peakhunt/chinese-diesel-heater-esp32/README.md

# Hello World Example

Dangerous! No safety functions implemented on purpose of  
full manual control!
