peakhunt/chinese-diesel-heater-esp32/how_to_build.txt

# install vue cli
npm install -g @vue/cli

# build web front
cd web-front
npm install
npm run build

#
