peakhunt/chinese-diesel-heater-esp32/pcb/diesel-heater-esp32.kicad_pcb

## KiCad design pcb/diesel-heater-esp32.kicad_pcb (2021-02-26)

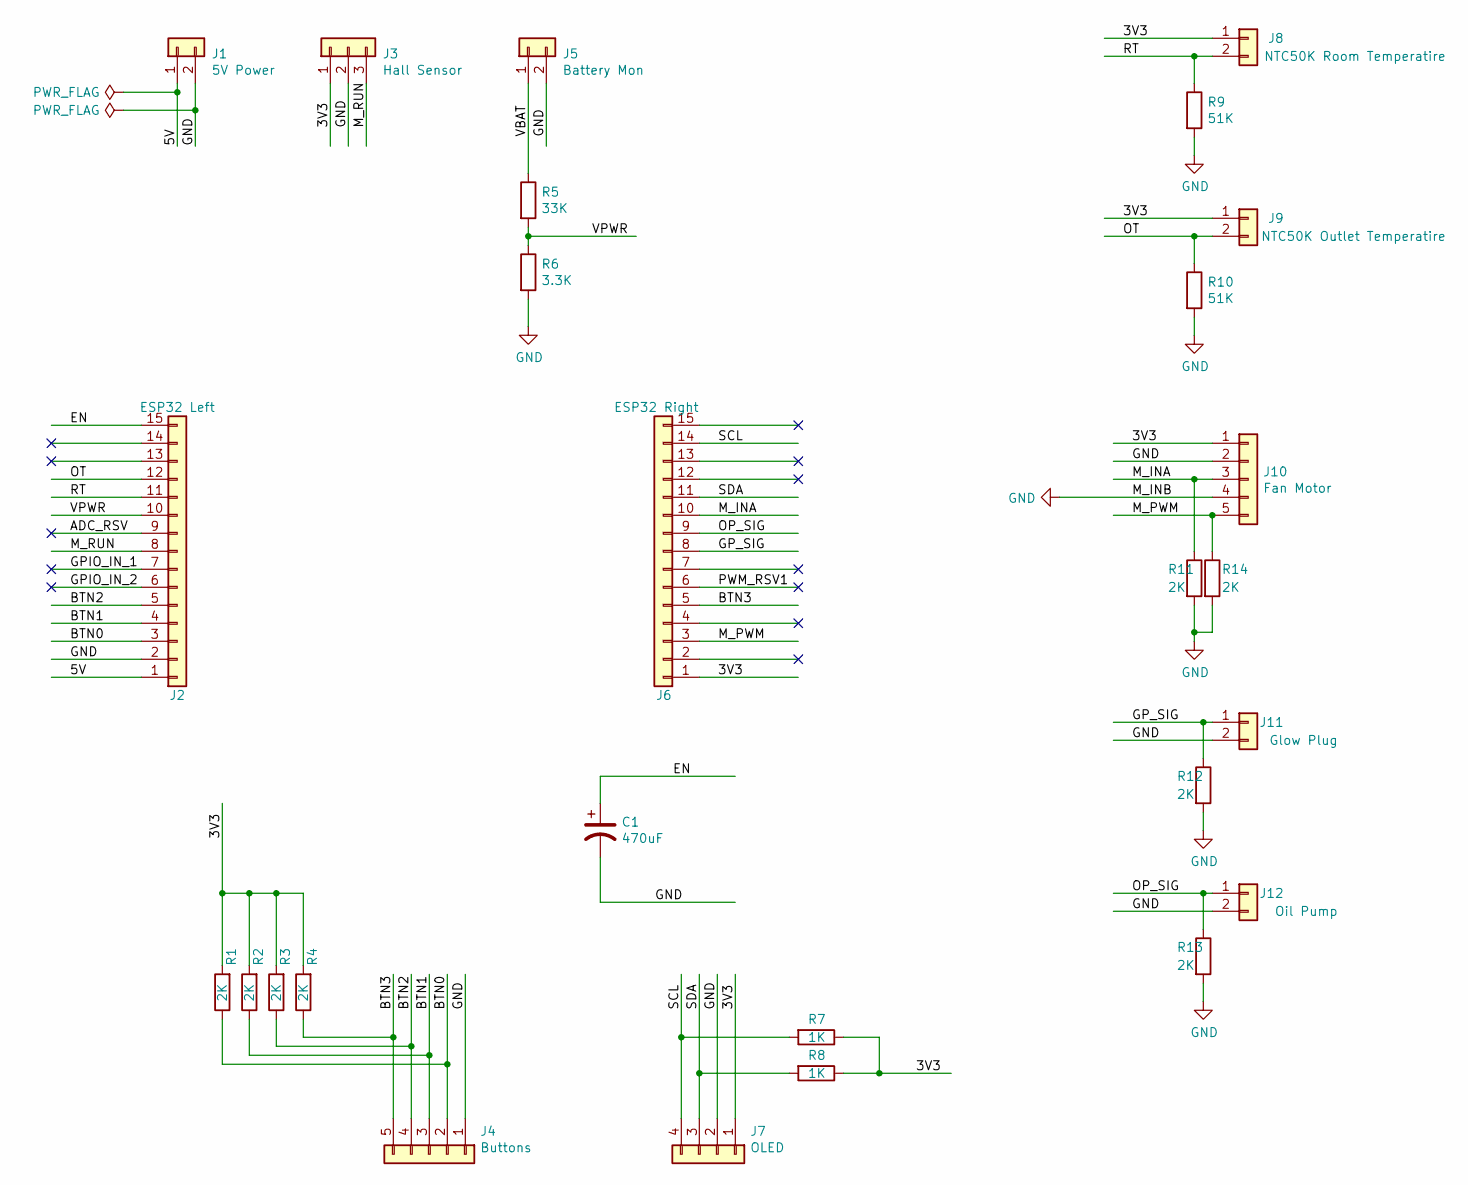
[picture p1: schematic diesel-heater-esp32.sch]

Parts:
C1: 470uF; CP_Radial_D6.3mm_P2.50mm
J1: 5V Power; JST_EH_B2B-EH-A_1x02_P2.50mm_Vertical
J2: ESP32 Left; PinSocket_1x15_P2.54mm_Vertical
J3: Hall Sensor; JST_EH_B3B-EH-A_1x03_P2.50mm_Vertical
J4: Buttons; JST_EH_B5B-EH-A_1x05_P2.50mm_Vertical
J5: Battery Mon; JST_EH_B2B-EH-A_1x02_P2.50mm_Vertical
J6: ESP32 Right; PinSocket_1x15_P2.54mm_Vertical
J7: OLED; JST_EH_B4B-EH-A_1x04_P2.50mm_Vertical
J8: NTC50K Room Temperatire; JST_EH_B2B-EH-A_1x02_P2.50mm_Vertical
J9: NTC50K Outlet Temperatire; JST_EH_B2B-EH-A_1x02_P2.50mm_Vertical
J10: Fan Motor; JST_EH_B5B-EH-A_1x05_P2.50mm_Vertical
J11: Glow Plug; JST_EH_B2B-EH-A_1x02_P2.50mm_Vertical
J12: Oil Pump; JST_EH_B2B-EH-A_1x02_P2.50mm_Vertical
R1, R2, R3, R4, R11, R12, R13, R14: 2K; R_0603_1608Metric_Pad0.98x0.95mm_HandSolder
R5: 33K; R_0603_1608Metric_Pad0.98x0.95mm_HandSolder
R6: 3.3K; R_0603_1608Metric_Pad0.98x0.95mm_HandSolder
R7, R8: 1K; R_0603_1608Metric_Pad0.98x0.95mm_HandSolder
R9, R10: 51K; R_0603_1608Metric_Pad0.98x0.95mm_HandSolder

Connections:
/3V3: J3.1, J6.1, J7.1, J8.1, J9.1, J10.1, R1.2, R2.2, R3.2, R4.2, R7.1, R8.1
/5V: J1.1, J2.1
/ADC_RSV: J2.9
/BTN0: J2.3, J4.2, R1.1
/BTN1: J2.4, J4.3, R2.1
/BTN2: J2.5, J4.4, R3.1
/BTN3: J4.5, J6.5, R4.1
/EN: C1.1, J2.15
/GPIO_IN_1: J2.7
/GPIO_IN_2: J2.6
/GP_SIG: J6.8, J11.1, R12.1
/M_INA: J6.10, J10.3, R11.1
/M_PWM: J6.3, J10.5, R14.1
/M_RUN: J2.8, J3.3
/OP_SIG: J6.9, J12.1, R13.1
/OT: J2.12, J9.2, R10.1
/PWM_RSV1: J6.6
/RT: J2.11, J8.2, R9.1
/SCL: J6.14, J7.4, R7.2
/SDA: J6.11, J7.3, R8.2
/VBAT: J5.1, R5.1
/VPWR: J2.10, R5.2, R6.1
GND: C1.2, J1.2, J2.2, J3.2, J4.1, J5.2, J7.2, J10.2, J10.4, J11.2, J12.2, R6.2, R9.2, R10.2, R11.2, R12.2, R13.2, R14.2

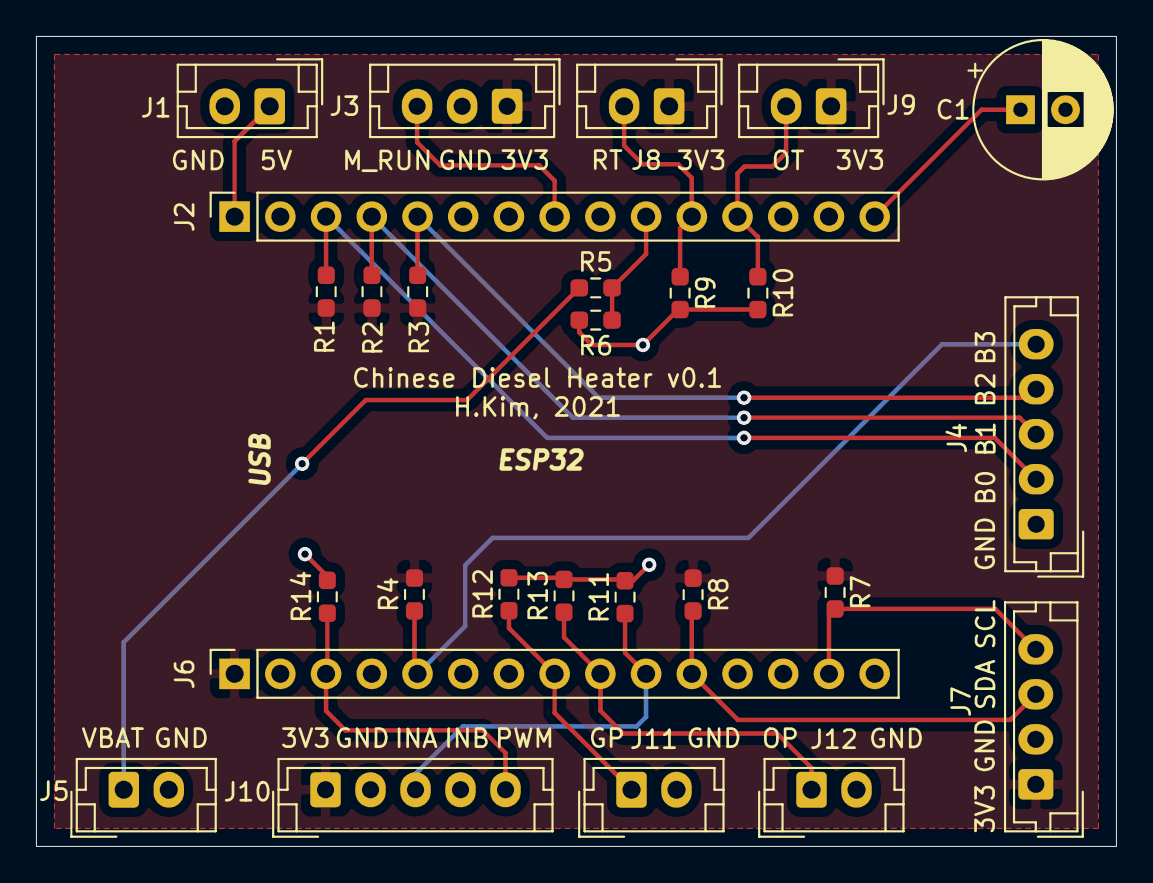
[picture p2: board diesel-heater-esp32.kicad_pcb from above]

Board: 2 copper layers, 60.0 x 45.0 mm, 27 parts (0 on the bottom side), 19 nets.
