peakhunt/chinese-diesel-heater-esp32/main/heater/gpio.h

#ifndef __GPIO_DEF_H__
#define __GPIO_DEF_H__

#include <stdbool.h>

typedef enum
{
  gpio_out_pin_5,
  gpio_out_pin_18,
  gpio_out_pin_19,
} gpio_out_pin_t;
#define GPIO_MAX_OUTPUT   (gpio_out_pin_19 + 1)

typedef enum
{
  gpio_in_pin_25,
  gpio_in_pin_26,
  gpio_in_pin_27,

  gpio_in_pin_13,   // BTN0
  gpio_in_pin_12,   // BTN1
  gpio_in_pin_14,   // BTN2
  gpio_in_pin_4,    // BTN3

} gpio_in_pin_t;
#define GPIO_MAX_INPUT    (gpio_in_pin_4 + 1)

typedef enum
{
  gpio_input_state_low,
  gpio_input_state_low_to_high,
  gpio_input_state_high,
  gpio_input_state_high_to_low,
} gpio_input_state_t;

typedef void (*gpio_listener)(gpio_in_pin_t pin, gpio_input_state_t state, void* arg);

extern void gpio_init(void);
extern void gpio_set(gpio_out_pin_t pin, bool v);
extern bool gpio_get(gpio_in_pin_t pin);
extern void gpio_set_debounce(gpio_in_pin_t pin, bool debounce);
extern void gpio_listen(gpio_in_pin_t pin, gpio_listener listener, void* arg);
extern gpio_input_state_t gpio_get_state(gpio_in_pin_t pin);

#endif /* !__GPIO_DEF_H__ */
