peakhunt/chinese-diesel-heater-esp32/main/heater/event_list.h

#ifndef __EVENT_LIST_DEF_H__
#define __EVENT_LIST_DEF_H__

#define DISPATCH_EVENT_TIMER_TICK           0
#define DISPATCH_EVENT_UART_CLI_RX          1

#define DISPATCH_EVENT_ADC_COMPLETE         5

#define DISPATCH_EVENT_PIN_CHANGE           8

#define DISPATCH_EVENT_HEATER_STATE         10

#endif //!__EVENT_LIST_DEF_H__
