peakhunt/chinese-diesel-heater-esp32/(commit log)

2020-12-17 finishing up esp32 version of heater controller
2020-12-18 adding web server
    [partitions.csv]
2021-01-26 fixed unstable connection issue
    [rest_server.c]
2021-01-26 working on temperature trand
2021-01-26 added support for temperature unit
2021-01-28 bug fixed for range check
    [shell.c]
2021-01-28 to prevent float point nan case
    [ntc50.c]
2021-01-28 changed esp32 settings for maximum performance
2021-02-01 close button bug fix
2021-02-05 changed prompt to Heater>
2021-02-13 added motor enable/disable pin for 3.3V to 5V inconvenience
2021-02-13 Revert "added motor enable/disable pin for 3.3V to 5V inconvenience"
    This reverts commit 5b280b5aa6429c6a0d15fb01282438d11590f488.
    this is a complete nonsense. we need a level shift ◙ircuit for enable pin as well.
    reverting commit and will look for a better level shifter IC.
    [fan.c, fan.h, heater.c]
2021-02-15 in honor of chinese diesel heater that kept me warm in this winter
2021-02-20 added room temperature on electorn build. added dummy roomTemp on REST api
2021-02-23 bug fix in adc channel map for ntc50k. added room temperature
    [heater.c, heater.h]
2021-02-23 added room temperature signal
2021-02-24 added more adc channels
2021-02-24 added M_INA pin
2021-02-24 preparing works for OLED with buttons
2021-02-25 code improvement. working on OLED display and buttons
2021-02-25 fixed pin conflict for OLED button3
    [app_heater.c, gpio.c, gpio.h]
2021-02-25 changed sys tick rate to 1KHz. changed heater task priority to max. set affinity of lwip task to cpu0
2021-02-25 adding pcb
    [diesel-heater-esp32.kicad_pcb, diesel-heater-esp32.sch]
2021-02-25 pcb text alignment
    [diesel-heater-esp32.kicad_pcb]
2021-02-25 capacitor value fixed. capacitor sized set to 6.3mm
    [diesel-heater-esp32.kicad_pcb, diesel-heater-esp32.sch]
2021-02-25 fixed bug in en bug workaround circult. capacitor should be connected to EN and grounded
    [diesel-heater-esp32.kicad_pcb, diesel-heater-esp32.sch]
2021-02-26 changed pcb layout to fit esp32 dimension
    [diesel-heater-esp32.kicad_pcb]
2021-02-26 releasing pcb 0.1
    [diesel-heater-esp32-B_Cu.gbr, diesel-heater-esp32-B_Mask.gbr, diesel-heater-esp32-B_Paste.gbr, diesel-heater-esp32-B_SilkS.gbr, diesel-heater-esp32-Edge_Cuts.gbr, diesel-heater-esp32-F_Cu.gbr, diesel-heater-esp32-F_Mask.gbr, diesel-heater-esp32-F_Paste.gbr]
